second-string/light-valves/doc/driver-doc/light_valve_driver_with_caps.png

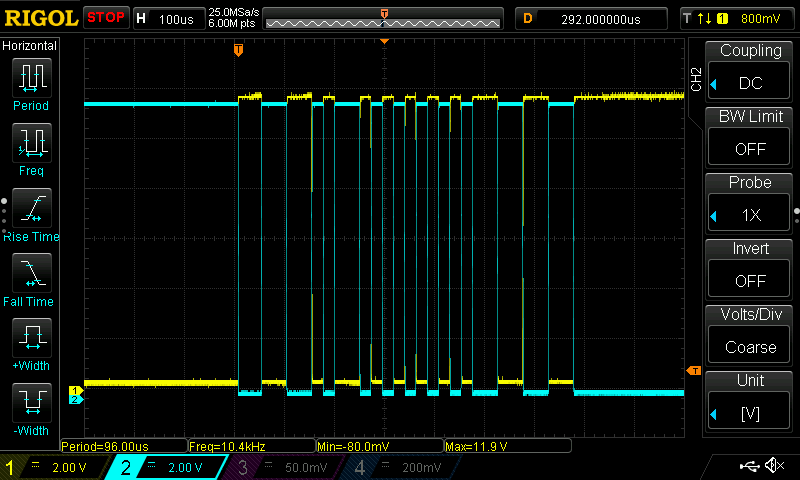
doc/driver-doc/light_valve_driver_with_caps.png
