second-string/light-valves/doc/driver-doc/light_valve_driver_without_caps.png

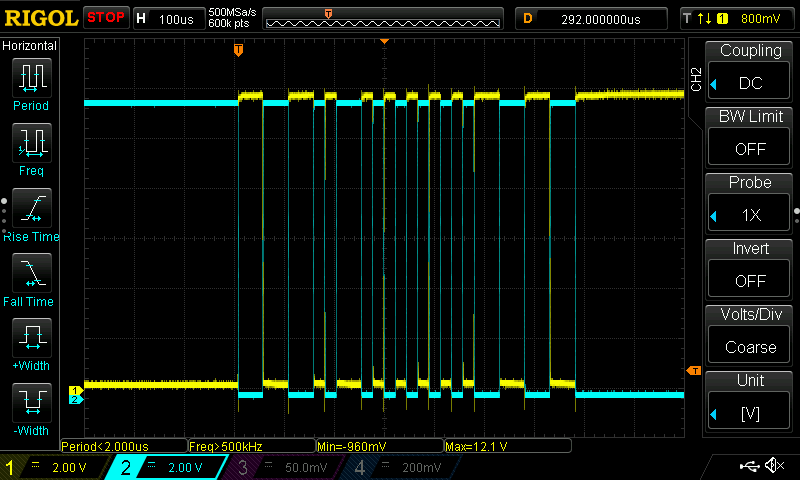
doc/driver-doc/light_valve_driver_without_caps.png
