second-string/light-valves/doc/driver-doc/light_valve_driver_without_caps_zoom.png

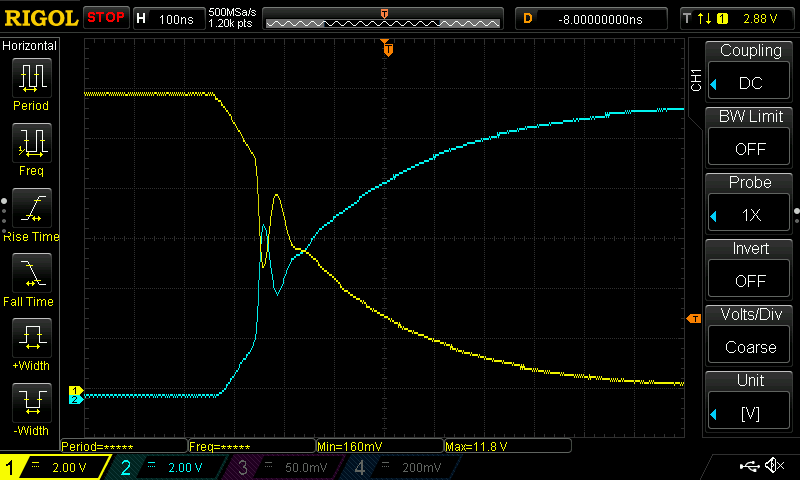
doc/driver-doc/light_valve_driver_without_caps_zoom.png
