second-string/light-valves/doc/node-doc/part_tracking_light_valve_node.xlsx

Part | Description | Link | Alternate(s)
MB6S | Full bridge rectifier | https://www.digikey.com/en/products/detail/smc-diode-solutions/MB6S/7244775
LDL1117S30R | XV to 5V linear regulator | https://www.digikey.com/en/products/detail/stmicroelectronics/LDL1117S30R/7102070 |  | MCU options
RCWCTE | Square test point | https://www.digikey.com/en/products/detail/koa-speer-electronics-inc/RCWCTE/11476558 |  |  | PN | package | Price (~100 qty) | notes
RB751V-40_R1_00001 | Schottky rectifier diode | https://www.digikey.com/en/products/detail/panjit-international-inc/RB751V-40-R1-00001/14661067 |  |  | PIC16F15255 | SOIC | $0.87
 |  |  |  |  | ATTiny104/204 | SOIC | $0.65 | Lots of stock!! 2XX series for tinys has 128B SRAM while 4XX has 256B but almost all 4XX sold out
NCP718ASN500T1G | cheaper and smaller linear 5V reg | https://www.digikey.com/en/products/detail/onsemi/NCP718ASN500T1G/9169770 | https://www.digikey.com/en/products/filter/pmic-voltage-regulators-linear/699 |  | ATTiny212/214/412/414/416 | SOIC | $0.45 | Only 90 stock total on uchip.com right now
BAV199S | cheaper / smaller rect | https://www.digikey.de/en/products/detail/panjit-international-inc/BAV199S-R1-00001/14661140 | https://www.digikey.de/en/products/filter/diodes-rectifiers-arrays/286 |  | ATtiny202/204/402/404/406 | SOIC | $0.75 | 406 has ~2k stock
For serial to UPDI:
Part | Description | Link
 | 470ohm resistor (ON BOARD)
BAT54 | SOT-23 schottky diode (either 54 or 54C) | https://www.digikey.com/en/products/detail/smc-diode-solutions/BAT54/6022503
RB751V-40_R1_00001 | Schottky diode power ORing (ON BOARD) | https://www.digikey.com/en/products/detail/panjit-international-inc/RB751V-40-R1-00001/14661067
