second-string/light-valves/doc/driver-doc/part_tracking_light_valve_group_driver.xlsx

Part | Description | Link | Alternate(s)
MCP14A0305 | Inverting/non-inverting line driver | https://www.digikey.com/en/products/detail/microchip-technology/MCP14A0305T-E-SN/9554954 | MIC4425/8
RT8258GJ6 | 1-15V adjustable switching regulator for 12v->5V | https://www.digikey.com/en/products/detail/richtek-usa-inc/RT8258GJ6/2546043 | https://www.digikey.com/en/products/filter/pmic-voltage-regulators-dc-dc-switching-regulators/739
~~TPS5403DR~~ | ~~3V3 fixed switching regulator~~ | ~~https://www.digikey.com/en/products/detail/texas-instruments/TPS5403DR/3671586~~ | ~~https://www.digikey.com/en/products/filter/pmic-voltage-regulators-dc-dc-switching-regulators/739
SP485CN-L/TR | RS485 transviever | https://www.digikey.com/en/products/detail/maxlinear-inc/SP485CN-L-TR/2471959 | https://www.digikey.com/en/products/filter/interface-drivers-receivers-transceivers/710
SRF4532-1R0Y | Driver data differential common mode choke | https://www.digikey.com/en/products/detail/bourns-inc/SRF4532-1R0Y/6134003 | https://www.digikey.com/en/products/filter/common-mode-chokes/839 | much cheaper alternatives in qty 10 vs. qty. 1
691137710004 | 4-line screw block terminal | https://www.digikey.com/en/products/detail/würth-elektronik/691137710004/6644053 | https://www.digikey.com/en/products/filter/terminal-blocks-wire-to-board/371
150080GS75000 | 0805 green LED | https://www.digikey.com/en/products/detail/würth-elektronik/150080GS75000/4489915 | https://www.digikey.com/en/products/filter/led-indication-discrete/105 | 0805s (alternate link) about 10c more than 0605s
150080SS75000 | 0805 red LED | https://www.digikey.com/en/products/detail/würth-elektronik/150080SS75000/4489921 | ^ | ^
SK53AFL-TP | Buck regulator schottky | https://www.digikey.com/en/products/detail/micro-commercial-co/SK53AFL-TP/4966275 | https://www.digikey.com/en/products/filter/diodes-rectifiers-single/280
NRS8040T150MJGJ | Buck regulator inductor | https://www.digikey.com/en/products/detail/taiyo-yuden/NRS8040T150MJGJ/2666011 | https://www.digikey.com/en/products/filter/fixed-inductors/71
CL31B106KBHNNNE | Buck regulator input cap(s) | https://www.digikey.com/en/products/detail/samsung-electro-mechanics/CL31B106KBHNNNE/5961251
CL21A226MAYNNNE | Buck regulator output cap(s) | https://www.digikey.com/en/products/detail/samsung-electro-mechanics/CL21A226MAYNNNE/10479857 | https://www.digikey.com/en/products/filter/ceramic-capacitors/60
CL21B103KBANNNC | Buck regulator BOOT cap | https://www.digikey.com/en/products/detail/samsung-electro-mechanics/CL21B103KBANNNC/3886673 | https://www.digikey.com/en/products/filter/ceramic-capacitors/60
RC0805FR-0791KL | Buck regulator 91k divider resistor | https://www.digikey.com/en/products/detail/yageo/RC0805FR-0791KL/728202 | https://www.digikey.com/en/products/filter/chip-resistor-surface-mount/52
RMCF0805FT17K4 | Buck regulator 17.4k divider resistor | https://www.digikey.com/en/products/detail/stackpole-electronics-inc/RMCF0805FT17K4/1712744 | https://www.digikey.com/en/products/filter/chip-resistor-surface-mount/52
ECQ-E2475KF | FET driver 4.7uF film bypass cap | https://www.digikey.com/en/products/detail/panasonic-electronic-components/ECQ-E2475KF/56516 | https://www.digikey.com/en/products/filter/film-capacitors/62
 | FET driver 0.1uF ceramic bypass cap
MMBZ9V1ALT1G | RS485 data TVS | https://www.digikey.com/en/products/detail/onsemi/MMBZ9V1ALT1G/921147 | https://www.digikey.com/en/products/filter/tvs-diodes/144
RCWCTE | Square grounding bar test point | https://www.digikey.com/en/products/detail/koa-speer-electronics-inc/RCWCTE/11476558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
