second-string/light-valves/light-valve-driver/light-valve-driver-firmware/src/cli_commands.c

#include <stdbool.h>
#include <stdio.h>
#include <string.h>

#include "FreeRTOS.h"
#include "task.h"

#include "FreeRTOS_CLI.h"

typedef enum {
    INFO_STATE_BANNER,
    INFO_STATE_VERSION,
    INFO_STATE_COMPILE_DATE,
} info_state_t;

static const char *banner[] = {
    " _ __      _______  ",
    "| |\\ \\    / /  __ \\ ",
    "| | \\ \\  / /| |  | |",
    "| |  \\ \\/ / | |  | |",
    "| |___\\  /  | |__| |",
    "|______\\/   |_____/ ",
    NULL,
};

BaseType_t cli_command_info(char *write_buffer, size_t write_buffer_size, const char *cmd_str) {
    static uint8_t      banner_line = 0;
    static info_state_t state       = INFO_STATE_BANNER;

    BaseType_t rval = pdFALSE;
    switch (state) {
        case INFO_STATE_BANNER: {
            if (banner[banner_line] == NULL) {
                state           = INFO_STATE_VERSION;
                write_buffer[0] = '\n';
                write_buffer[1] = 0x00;
                banner_line     = 0;
            } else {
                strcpy(write_buffer, banner[banner_line]);
                banner_line++;
            }

            rval = pdTRUE;
            break;
        }
        case INFO_STATE_VERSION: {
            char version[41];
            sprintf(version, "Version: %s", "0.1");
            strcpy(write_buffer, version);
            state = INFO_STATE_COMPILE_DATE;

            rval = pdTRUE;
            break;
        }
        case INFO_STATE_COMPILE_DATE: {
            char version[60];
            sprintf(version, "Compiled on %s at %s", "XXXX", "XXXX");
            strcpy(write_buffer, version);

            state = INFO_STATE_BANNER;
            rval  = pdFALSE;
            break;
        }
        default:
            configASSERT(false);
    }

    return rval;
}

void cli_command_register_all() {
    static const CLI_Command_Definition_t info_cmd = {
        .pcCommand                   = "info",
        .pcHelpString                = "info: Print info about the firmware",
        .pxCommandInterpreter        = cli_command_info,
        .cExpectedNumberOfParameters = 0,
    };

    FreeRTOS_CLIRegisterCommand(&info_cmd);
}
