second-string/light-valves/(commit log)

2022-07-27 First commit of basic node firmware. Interrupting on rising/falling on data pin, full pseudo-state machine written out in comment
2022-07-27 Mostly full state machine for decoding message, including initial clock period measurement, frame start bits, address and data bits. Only works down to speed of 200us/clock period from debug arduino 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
2022-07-27 Get timer registers set up and working with interrupt at (current) full packet period. Not doing anything with timeout yet
2022-07-27 Correctly set up and run light valve opposite PWM signals off TCD. First pass as linear opacity map but needs tweaking. Currently has debug code in loop and pin dirs are a bit off to use DATA in pin 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
    [light-valve-node-firmware.ino]
2022-07-27 Verified working packet rx at up to 100us clock period and 32 packets all separated by 2ms, both when all pacekts this addr and also when half other addr. 50us clock period working but drops a lot of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
2022-07-27 Move .git from just light-valve-node-firmware firmware dir to top level to include doc and driver
    [light_valve_node_bom.xlsx, light_valve_node_generated_bom.csv, part_tracking_light_valve_group_driver.xlsx, part_tracking_light_valve_node.xlsx]
2022-07-29 Got node working down to 50us clock period. Fixed issue with arduino driver 0s taking a bit longer than clock period since two pin changes. This pushed what should have been registered as a clock tra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
    [light-valve-driver-arduino-firmware.ino, light-valve-node-firmware.ino]
2022-08-13 Add gerbers for driver rev 1 and node rev 1.1, updated part tracking and boms for both after jlcpcb and digikey orders. Added new datasheets for driver rev 1
    [light_valve_driver_rev_1_bom.xlsx, light_valve_driver_rev_1_generated_bom.csv, light_valve_node_rev_1_1_bom.xlsx, light_valve_node_rev_1_1_generated_bom.csv, light_valve_node_rev_1_bom.xlsx, light_valve_node_rev_1_generated_bom.csv, part_tracking_light_valve_group_driver.xlsx, part_tracking_light_valve_node.xlsx]
2022-08-13 Move driver firmware from 'group-driver' dir to just 'driver'. Generated accurate stm32cube LL code to actual match layout of rev 1 board functionality driven by blue pill dev board
2022-08-13 switch over to a bit more debugging code in node firmware for now for testing dropped packets when upping clock speed
2022-08-15 Add GPIO driver and basic heartbeat loop task
2022-08-15 Add CLI source files, regenerate code to use HAL for both uarts for now
2022-08-15 Add info cli command and cli_task code to process uart stream and execute matching commands. Compiling, untested on hardware. Uses blocking HAL uart impl
2022-08-15 Fix issues with freertos config (stack size of default task too small, total heap too small to create tasks) and cli/uart tasks. Working cli and UART output in blocking mode
    [app_main.c, cli_task.c, uart.c]
2022-08-19 Remove dumb extra '-g' file from driver makefile bug
2022-08-19 Pin changes, HW uart use/init code, and cleanup of node code to support rev 1.1 board. All functionality tested except for data-in RX and parse
2022-08-22 Switch arduino driver firmware output pin to 10 from 11 because 11 is shorted
    [light-valve-driver-arduino-firmware.ino]
2022-08-22 Skeleton input and output data tasks to process and emit data. Full driver rev 1.0 board bringup complete and successful
2022-08-23 5us interrupt incrementing 'clock' and successfully sending simple packets at 50us output clock period. Switched to TIM1 to use 72mhz clock and still spinlocking for us delay since freertos construct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
    [light-valve-driver-arduino-firmware.ino, output_data_task.c, output_data_task.h]
2022-08-25 Update node firmware to remove all the debugging comments, remove debugging cycle through opacities so driver packets are only thing that affects opacity, and add startup blink sequence to verify pow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
2022-08-25 Update driver makefile to support adding multiple cubemx files to custom compile target in order to add our inc dir (neede for both main.c and *_it.c for now)
2022-08-25 Add proper enqueue/dequeue path for data packets to flow through rtos and out to node. Cleanup debugging and testing around output_data_task
2022-08-31 Switch incoming xcvr uart to 16-byte DMA. Also add logic for resetting dma on partial packet reception to get into good state before next packet incoming. Currently task notifying when incoming packe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
    [app_main.c, input_data_task.c, input_data_task.h, output_data_task.c, output_data_task.h, send_test_controller_packets.py]
2022-09-11 Switch CLI tx uart to DMA and remove unused uart init params for different buffer / queue sizes
2022-09-11 Fix queue data passing between in and out tasks, set input rs485 baud rate to 115200 for initial dev then can be bumped to 921600 later
    [output_data_task.c]
2022-09-17 Refactor entire test packet script. Supports manual debugging packets as before, and also includes 6 new patterns that automatically address all 16 nodes for a single driver
2022-09-17 Correctly delay ~1.5ms between each node packet so their timeout timers reset and are ready to receive a new packet
    [output_data_task.c]
2022-10-15 Remove unneeded uC datasheet and update part tracking excel for 1.2 planned parts
    [part_tracking_light_valve_node.xlsx]
2022-10-15 Seperate driver packet build and send into two functions for TD use and manual script exec use
2022-10-23 Pad node_data for a driver packet with zeros for any nodes not received from caller
2022-10-23 Add node addr indication on startup. Remove some dead debug code and disable millis() call to keep main loop as tight / deterministic as possible
    [light-valve-node-firmware.ino]
2023-02-26 Add led indication for driver of packet RX and each full 16-node packet TX
2023-02-26 Add generated bom/gerbers for node rev 1.3. Also add some datasheets
    [light_valve_node_rev_1_3_bom.xlsx, light_valve_node_rev_1_3_generated_bom.csv]
2023-02-26 Add driver rev 1.1 generated bom and gerbers. Add debug scope shots for driver output driving with extra caps removed
    [light_valve_driver_rev_1_1_bom.xlsx, light_valve_driver_rev_1_1_generated_bom.csv]
2023-02-26 Shorten blink rate for node boot indication from 500ms on/off to 300ms on/off
    [light-valve-node-firmware.ino]
2023-03-09 Full basic pattern set from initial script working (plus extras). Current patterns are: ramp blink fade blink all on all off triangle wave one by one row by row
    Note that patterns where every square in a driver group is turned off (all off, one by one, etc), the final all zero frame does not send. This is an issue within TD, as the chops don't execute when all values in channel are zero. To be fixed
2023-03-09 Fix test packet script to work correctly with multiple drivers. Add blink, blink_drivers, one_by_one_rev patterns. Adds 2ms sleep at the end of send_driver_packet to account for driver packets stompi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
    [send_test_controller_packets.py]
2023-05-13 Swtich CGIO execute to just execute to run grid update once every frame, no more no less. Fixes problem with not turning off squares and over-transmission of each channel
2023-05-14 Clean up UI and switch from sliders to BPM and Multiplier text entry fields. Add Pulse button to allow manual running of blink for more interesting patterns
2023-05-29 Fix ramp UI and split into ramp wire and circular ramp. Add secondary buttons for both to control orientation or style
2024-10-19 update gitignore to ignore bundled gcc for proper driver linking locally
