second-string/light-valves/(notices)

Notices in the files:
light-valve-node/avr_tcd_testing/avr_tcd_testing.ino:
(c) 2021 Microchip Technology Inc. and its subsidiaries.
